bradjmsu/canon-mc16-chip-reset/plug/mc16-chip-plug.3mf

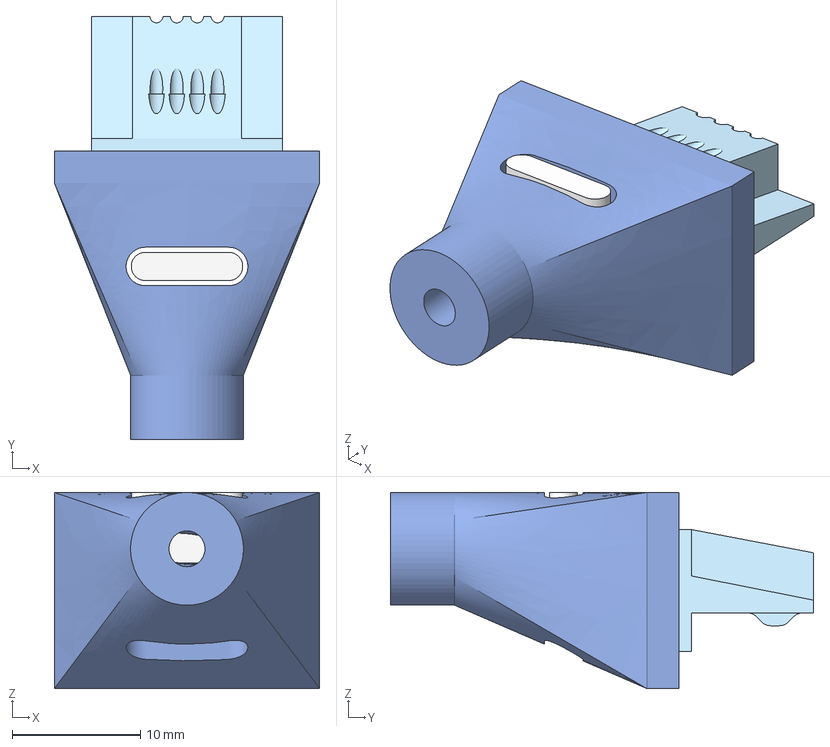
[picture p3: CAD file, 2026-11-07]
plug/mc16-chip-plug.3mf
20.7 x 33.0 x 15.3 mm
