bradjmsu/canon-mc16-chip-reset/plug/part3-cable-shell.stl

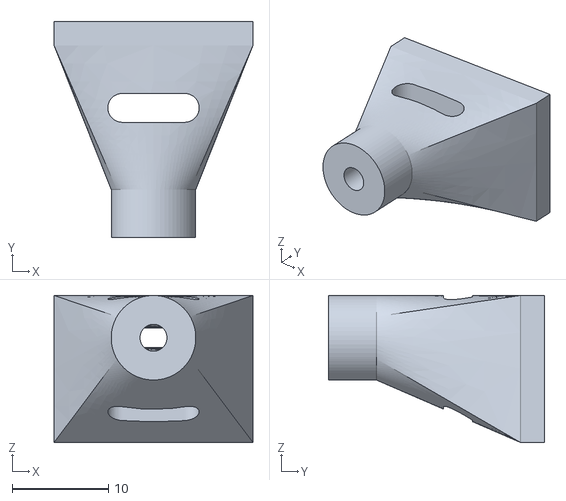
[picture p4: CAD file, 2026-11-07]
plug/part3-cable-shell.stl
20.7 x 22.5 x 15.3
