bradjmsu/canon-mc16-chip-reset/plug/part4-insert.stl

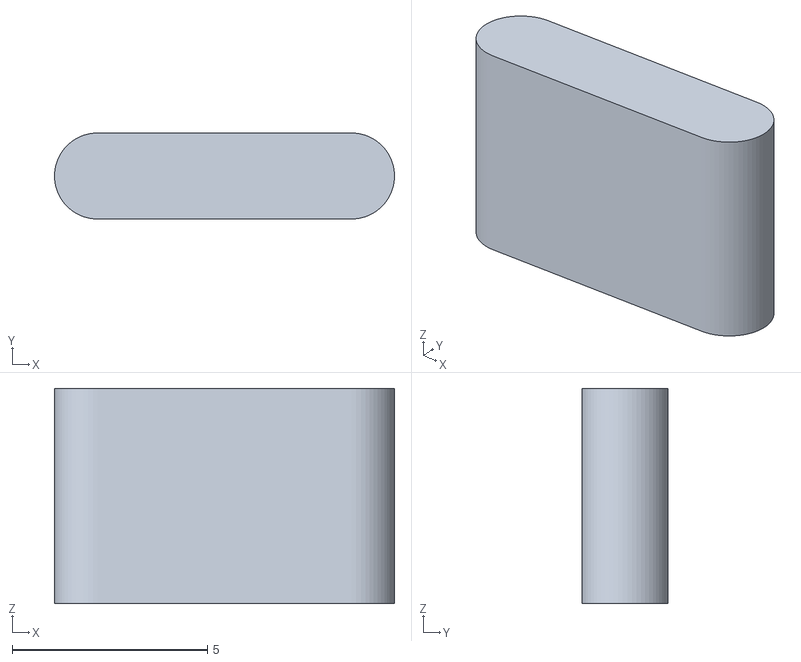
[picture p5: CAD file, 2026-11-07]
plug/part4-insert.stl
8.70 x 2.20 x 5.50
