bradjmsu/canon-mc16-chip-reset/plug/part1-contact-block.stl

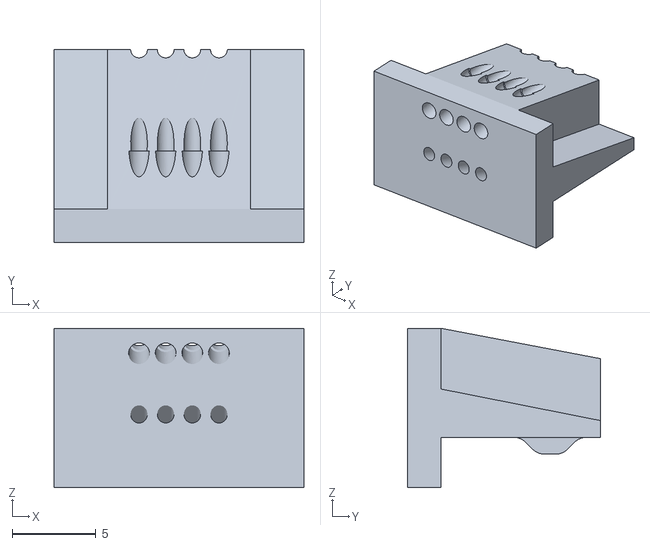
[picture p6: CAD file, 2026-11-07]
plug/part1-contact-block.stl
14.9 x 11.5 x 9.50
